timdeangeo/RefractionSeismograph/README.md

# RefractionSeismograph
Build your own refraction seismograph using Arduino components.
